vcabbage/levels54/docs/levels54-keymap.pdf

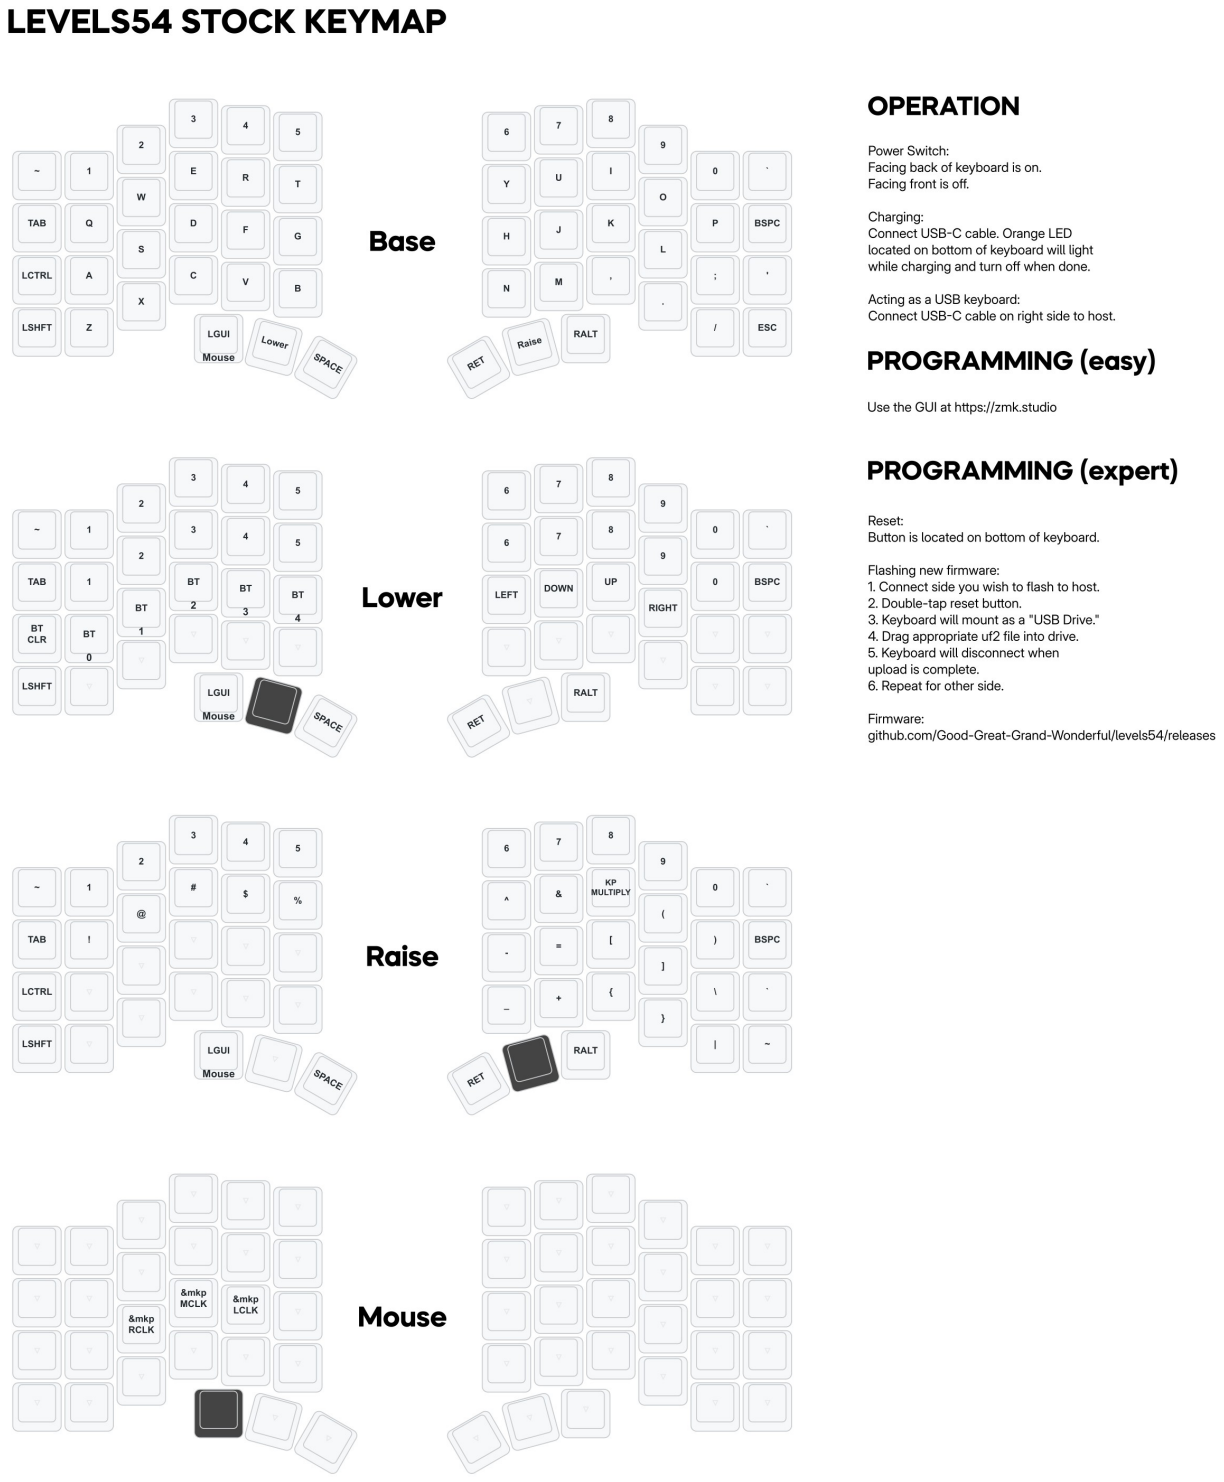
[picture p1: page 1]
