vcabbage/levels54/docs/manu-page1.pdf

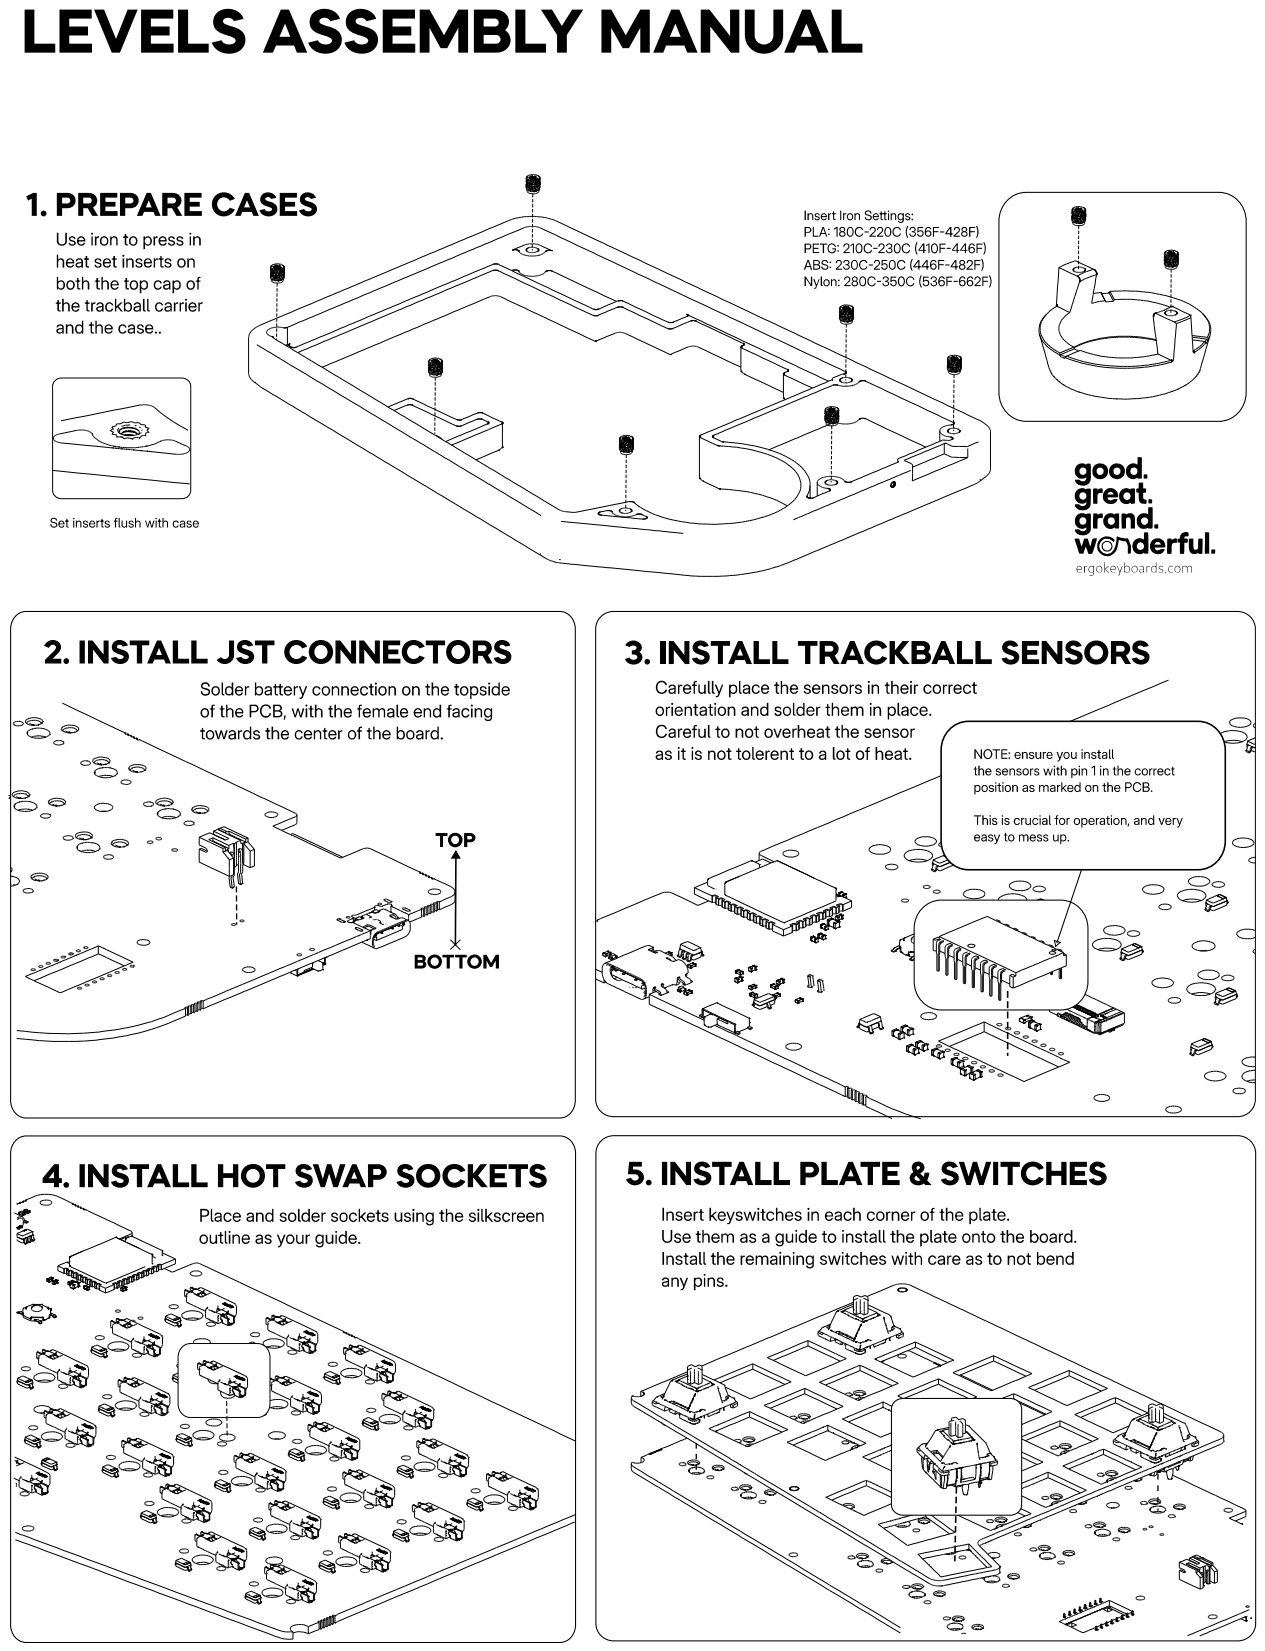
[picture p2: page 1]
