vcabbage/levels54/docs/manu-page2.pdf

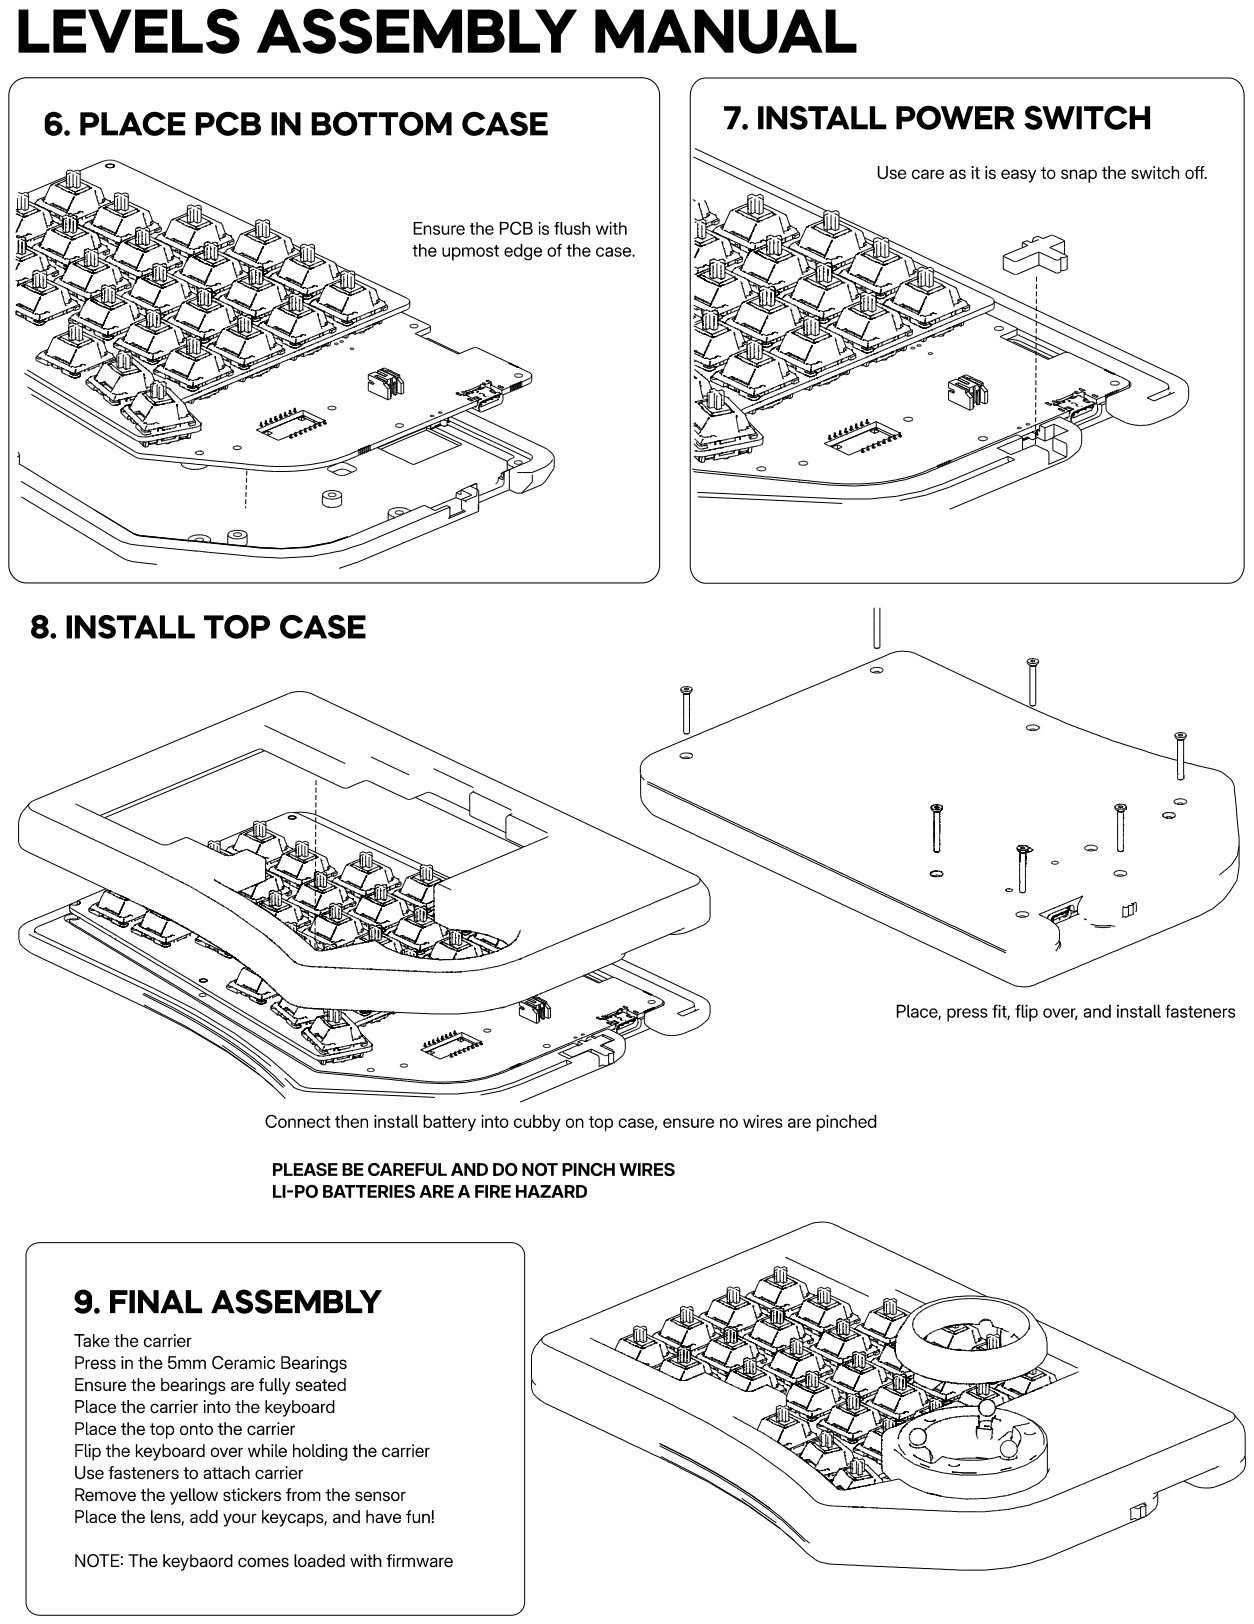
[picture p3: page 1]
