vcabbage/levels54/kicad/levels.kicad_pcb

## KiCad design kicad/levels.kicad_pcb (2026-05-02)

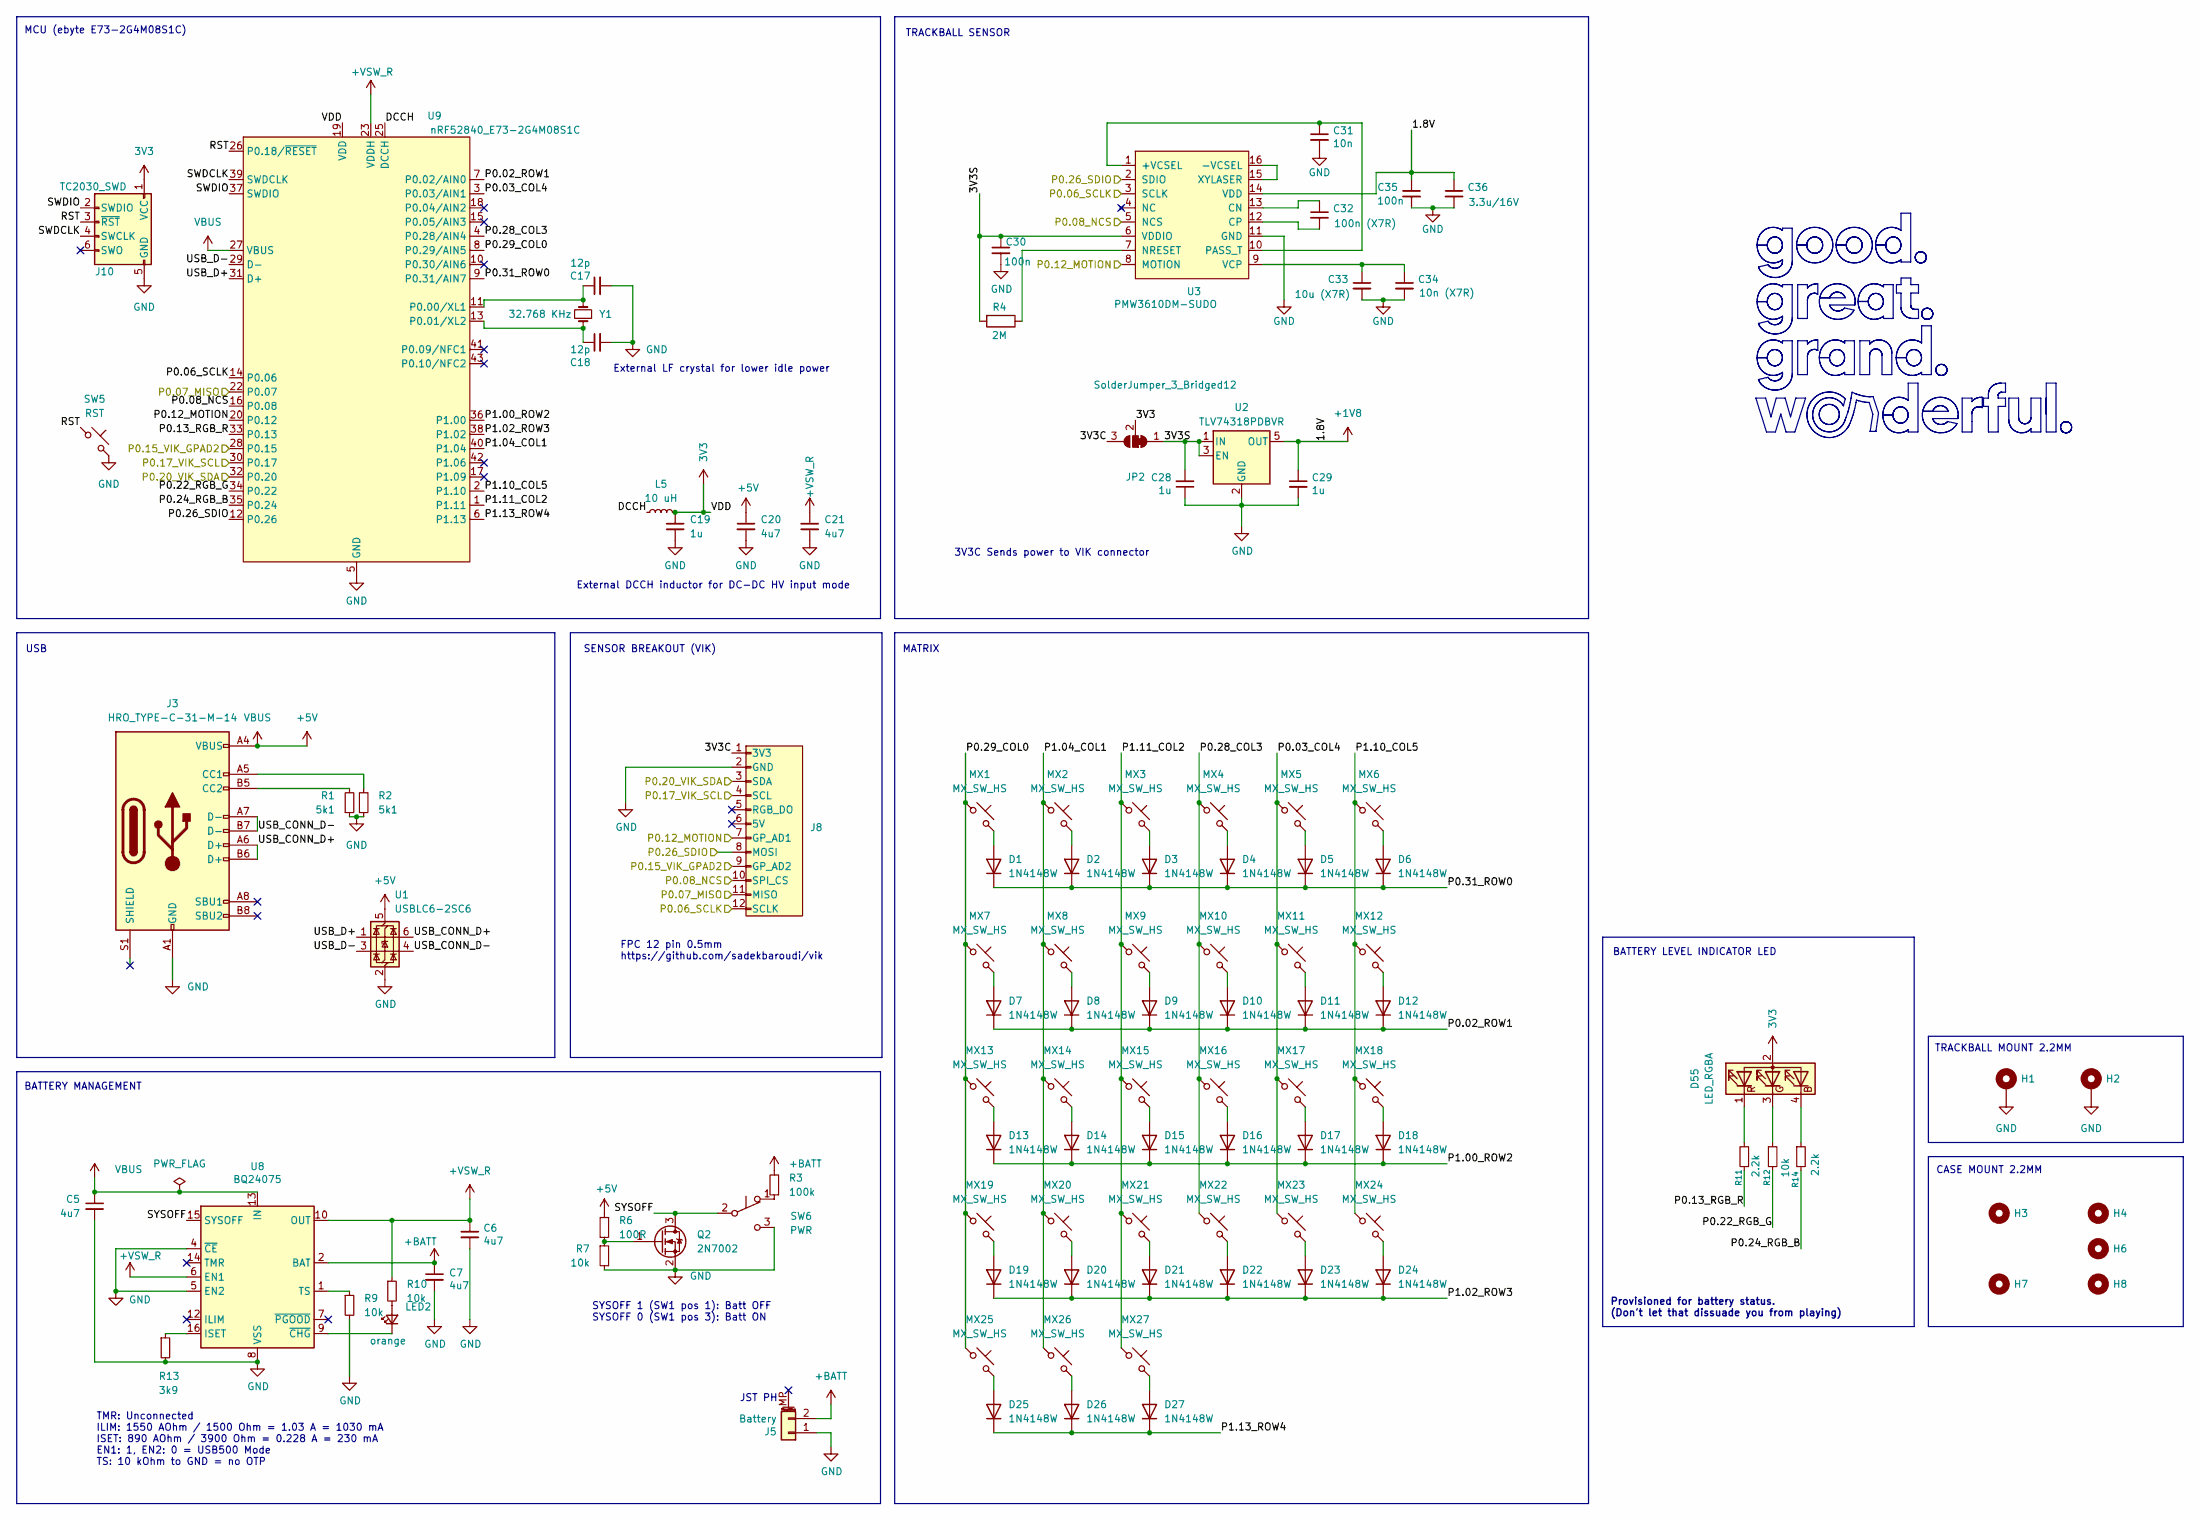
[picture p4: schematic matrix.kicad_sch, Levels]

Parts:
C5, C6, C7, C20, C21: 4u7; C_0402_1005Metric
C17, C18: 12p; C_0402_1005Metric
C19: 1u; C_0402_1005Metric
C28, C29: 1u; C_0603_1608Metric; LCSC C15849
C30, C35: 100n; C_0603_1608Metric; LCSC C14663
C31: 10n; C_0603_1608Metric; LCSC C57112
C32: 100n (X7R); C_0603_1608Metric; LCSC C14663
C33: 10u (X7R); C_0603_1608Metric; LCSC C237435
C34: 10n (X7R); C_0603_1608Metric; LCSC C57112
C36: 3.3u/16V; C_0603_1608Metric; LCSC C342962
D1, D2, D3, D4, D5, D6, D7, D8, D9, D10, D11, D12, D13, D14, D15, D16, D17, D18, D19, D20, D21, D22, D23, D24, D25, D26, D27: 1N4148W; D_SOD-123
D55: LED_RGBA; LED_NH-B1515RGBA-HF
H1, H2: MountingHole_Pad; MountingHole_2.2mm_M2_ISO7380_Pad
H3, H4, H6, H7: MountingHole; MountingHole_3.2mm_M3_DIN965
H8: MountingHole; MountingHole_2.2mm_M2_ISO7380
J3: HRO_TYPE-C-31-M-14; USB_C_Receptacle_HRO_TYPE-C-31-M-14
J5: Battery; JST_PH_S2B-PH-K_1x02_P2.00mm_Horizontal; LCSC C505023
J8: vik-keyboard-connector-horizontal
J10: TC2030_SWD; CON_TC2030_outlined
JP2: SolderJumper_3_Bridged12; SolderJumper-3_P1.3mm_Bridged12_RoundedPad1.0x1.5mm_NumberL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
L5: 10 uH; L_0603_1608Metric; LCSC C92982
LED2: orange; LED_0402_1005Metric
MX1, MX2, MX3, MX4, MX5, MX6, MX7, MX8, MX9, MX10, MX11, MX12, MX13, MX14, MX15, MX16, MX17, MX18, MX19, MX20, MX21, MX22, MX23, MX24, MX25, MX26, MX27: MX_SW_HS; SW_MX_HS_CPG151101S11_1u
Q2: 2N7002; SOT-23
R1, R2: 5k1; R_0402_1005Metric
R3: 100k; R_0402_1005Metric
R4: 2M; R_0603_1608Metric; LCSC C22976
R6: 100R; R_0402_1005Metric
R7, R9, R10, R12: 10k; R_0402_1005Metric
R11, R14: 2.2k; R_0402_1005Metric
R13: 3k9; R_0402_1005Metric
SW5: RST; SW_SPST_SKQG_WithStem
SW6: PWR; SW_MSK12C02-HB
U1: USBLC6-2SC6; SOT-23-6
U2: TLV74318PDBVR; SOT-23-5; LCSC C485152
U3: PMW3610DM-SUDO; PMW3610DM-SUDU 16Pin
U8: BQ24075; VQFN-16-1EP_3x3mm_P0.5mm_EP1.6x1.6mm
U9: nRF52840_E73-2G4M08S1C; LCSC C356849
Y1: 32.768 KHz; Crystal_SMD_2012-2Pin_2.0x1.2mm; LCSC C55208

Connections:
3V3: C19.1, D55.2 (A), J10.1 (VCC), JP2.2 (C), L5.2, U9.19 (VDD); also elsewhere on the board
+1V8: C29.1, C35.1, C36.1, U2.5 (OUT), U3.14 (VDD); also elsewhere on the board
+5V: C5.1, C20.1, J3.A4 (VBUS), J3.A9 (VBUS), J3.B4 (VBUS), J3.B9 (VBUS), R6.1, U1.5 (VBUS), U8.13 (IN), U9.27 (VBUS); also elsewhere on the board
+BATT: C7.1, J5.2, R3.2, U8.2 (BAT), U8.3 (BAT); also elsewhere on the board
+VSW_R: C6.1, C21.1, R10.1, U8.6 (EN1), U8.10 (OUT), U8.11 (OUT), U9.23 (VDDH)
/Right/3V3C: J8.1 (3V3), JP2.3 (B)
/Right/3V3S: C28.2, C30.1, JP2.1 (A), R4.2, U2.1 (IN), U2.3 (EN), U3.6 (VDDIO)
/Right/DCCH: L5.1, U9.25 (DCCH)
/Right/P0.02_ROW1: D7.1 (K), D8.1 (K), D9.1 (K), D10.1 (K), D11.1 (K), D12.1 (K), U9.7 (P0.02/AIN0)
/Right/P0.03_COL4: MX5.1, MX11.1, MX17.1, MX23.1, U9.3 (P0.03/AIN1)
/Right/P0.06_SCLK: J8.12 (SCLK), U3.3 (SCLK), U9.14 (P0.06)
/Right/P0.07_MISO: J8.11 (MISO), U9.22 (P0.07)
/Right/P0.08_NCS: J8.10 (SPI_CS), U3.5 (NCS), U9.16 (P0.08)
/Right/P0.12_MOTION: J8.7 (GP_AD1), U3.8 (MOTION), U9.20 (P0.12)
/Right/P0.13_RGB_R: R11.1, U9.33 (P0.13)
/Right/P0.15_VIK_GPAD2: J8.9 (GP_AD2), U9.28 (P0.15)
/Right/P0.17_VIK_SCL: J8.4 (SCL), U9.30 (P0.17)
/Right/P0.20_VIK_SDA: J8.3 (SDA), U9.32 (P0.20)
/Right/P0.22_RGB_G: R12.2, U9.34 (P0.22)
/Right/P0.24_RGB_B: R14.2, U9.35 (P0.24)
/Right/P0.26_SDIO: J8.8 (MOSI), U3.2 (SDIO), U9.12 (P0.26)
/Right/P0.28_COL3: MX4.1, MX10.1, MX16.1, MX22.1, U9.4 (P0.28/AIN4)
/Right/P0.29_COL0: MX1.1, MX7.1, MX13.1, MX19.1, MX25.1, U9.8 (P0.29/AIN5)
/Right/P0.31_ROW0: D1.1 (K), D2.1 (K), D3.1 (K), D4.1 (K), D5.1 (K), D6.1 (K), U9.9 (P0.31/AIN7)
/Right/P1.00_ROW2: D13.1 (K), D14.1 (K), D15.1 (K), D16.1 (K), D17.1 (K), D18.1 (K), U9.36 (P1.00)
/Right/P1.02_ROW3: D19.1 (K), D20.1 (K), D21.1 (K), D22.1 (K), D23.1 (K), D24.1 (K), U9.38 (P1.02)
/Right/P1.04_COL1: MX2.1, MX8.1, MX14.1, MX20.1, MX26.1, U9.40 (P1.04)
/Right/P1.10_COL5: MX6.1, MX12.1, MX18.1, MX24.1, U9.2 (P1.10)
/Right/P1.11_COL2: MX3.1, MX9.1, MX15.1, MX21.1, MX27.1, U9.1 (P1.11)
/Right/P1.13_ROW4: D25.1 (K), D26.1 (K), D27.1 (K), U9.6 (P1.13)
/Right/RST: J10.3 (~RST), SW5.1, U9.26 (P0.18/~RESET)
/Right/SWDCLK: J10.4 (SWCLK), U9.39 (SWDCLK)
/Right/SWDIO: J10.2 (SWDIO), U9.37 (SWDIO)
/Right/SYSOFF: Q2.3 (D), SW6.2 (B), U8.15 (SYSOFF)
/Right/USB_CONN_D+: J3.A6 (D+), J3.B6 (D+), U1.6 (I/O1)
/Right/USB_CONN_D-: J3.A7 (D-), J3.B7 (D-), U1.4 (I/O2)
/Right/USB_D+: U1.1 (I/O1), U9.31 (D+)
/Right/USB_D-: U1.3 (I/O2), U9.29 (D-)
GND: C5.2, C6.2, C7.2, C17.2, C18.2, C19.2, C20.2, C21.2, C28.1, C29.2, C30.2, C31.2, C33.2, C34.2, C35.2, C36.2, H1.1, H2.1, J3.A1 (GND), J3.A12 (GND), J3.B1 (GND), J3.B12 (GND), J5.1, J8.2 (GND), J10.5 (GND), Q2.2 (S), R1.1, R2.1, R7.2, R9.2, R13.2, SW5.2, SW6.3 (C), U1.2 (GND), U2.2 (GND), U3.11 (GND), U8.4 (~CE), U8.5 (EN2), U8.8 (VSS), U8.17 (VSS), U9.5 (GND), U9.21 (GND), U9.24 (GND); also elsewhere on the board
unnamed: D1.2 (A), MX1.2
unnamed: D2.2 (A), MX2.2
unnamed: D3.2 (A), MX3.2
unnamed: D4.2 (A), MX4.2
unnamed: D5.2 (A), MX5.2
unnamed: D6.2 (A), MX6.2
unnamed: D7.2 (A), MX7.2
unnamed: D8.2 (A), MX8.2
unnamed: D9.2 (A), MX9.2
unnamed: D10.2 (A), MX10.2
unnamed: D11.2 (A), MX11.2
unnamed: D12.2 (A), MX12.2
unnamed: D13.2 (A), MX13.2
unnamed: D14.2 (A), MX14.2
unnamed: D15.2 (A), MX15.2
unnamed: D16.2 (A), MX16.2
unnamed: D17.2 (A), MX17.2
unnamed: D18.2 (A), MX18.2
unnamed: D19.2 (A), MX19.2
unnamed: D20.2 (A), MX20.2
unnamed: D21.2 (A), MX21.2
unnamed: D22.2 (A), MX22.2
unnamed: D23.2 (A), MX23.2
unnamed: D24.2 (A), MX24.2
unnamed: D25.2 (A), MX25.2
unnamed: D26.2 (A), MX26.2
unnamed: D27.2 (A), MX27.2
unnamed: D55.4 (BK), R14.1
unnamed: D55.3 (GK), R12.1
unnamed: D55.1 (RK), R11.2
unnamed: J3.A5 (CC1), R2.2
unnamed: J3.B5 (CC2), R1.2
unnamed: LED2.2 (A), R10.2
unnamed: LED2.1 (K), U8.9 (~CHG)
unnamed: Q2.1 (G), R6.2, R7.1
unnamed: R3.1, SW6.1 (A)
unnamed: C31.1, U3.1 (+VCSEL), U3.10 (PASS_T)
unnamed: U3.15 (XYLASER), U3.16 (-VCSEL)
unnamed: C32.1, U3.13 (CN)
unnamed: C32.2, U3.12 (CP)
unnamed: R4.1, U3.7 (NRESET)
unnamed: C33.1, C34.1, U3.9 (VCP)
unnamed: R13.1, U8.16 (ISET)
unnamed: R9.1, U8.1 (TS)
unnamed: C17.1, U9.11 (P0.00/XL1), Y1.2
unnamed: C18.1, U9.13 (P0.01/XL2), Y1.1

Notes on the sheet:
BATTERY LEVEL INDICATOR LED
JST PH
Provisioned for battery status. (Don't let that dissuade you from playing)
MCU (ebyte E73-2G4M08S1C)
TRACKBALL SENSOR
SENSOR BREAKOUT (VIK)
TMR: Unconnected ILIM: 1550 AOhm / 1500 Ohm = 1.03 A = 1030 mA ISET: 890 AOhm / 3900 Ohm = 0.228 A = 230 mA EN1: 1, EN2: 0 = USB500 Mode TS: 10 kOhm to GND = no OTP
FPC 12 pin 0.5mm https://github.com/sadekbaroudi/vik
BATTERY MANAGEMENT
USB
CASE MOUNT 2.2MM
3V3C Sends power to VIK connector
External LF crystal for lower idle power
MATRIX
SYSOFF 1 (SW1 pos 1): Batt OFF SYSOFF 0 (SW1 pos 3): Batt ON
External DCCH inductor for DC-DC HV input mode
TRACKBALL MOUNT 2.2MM

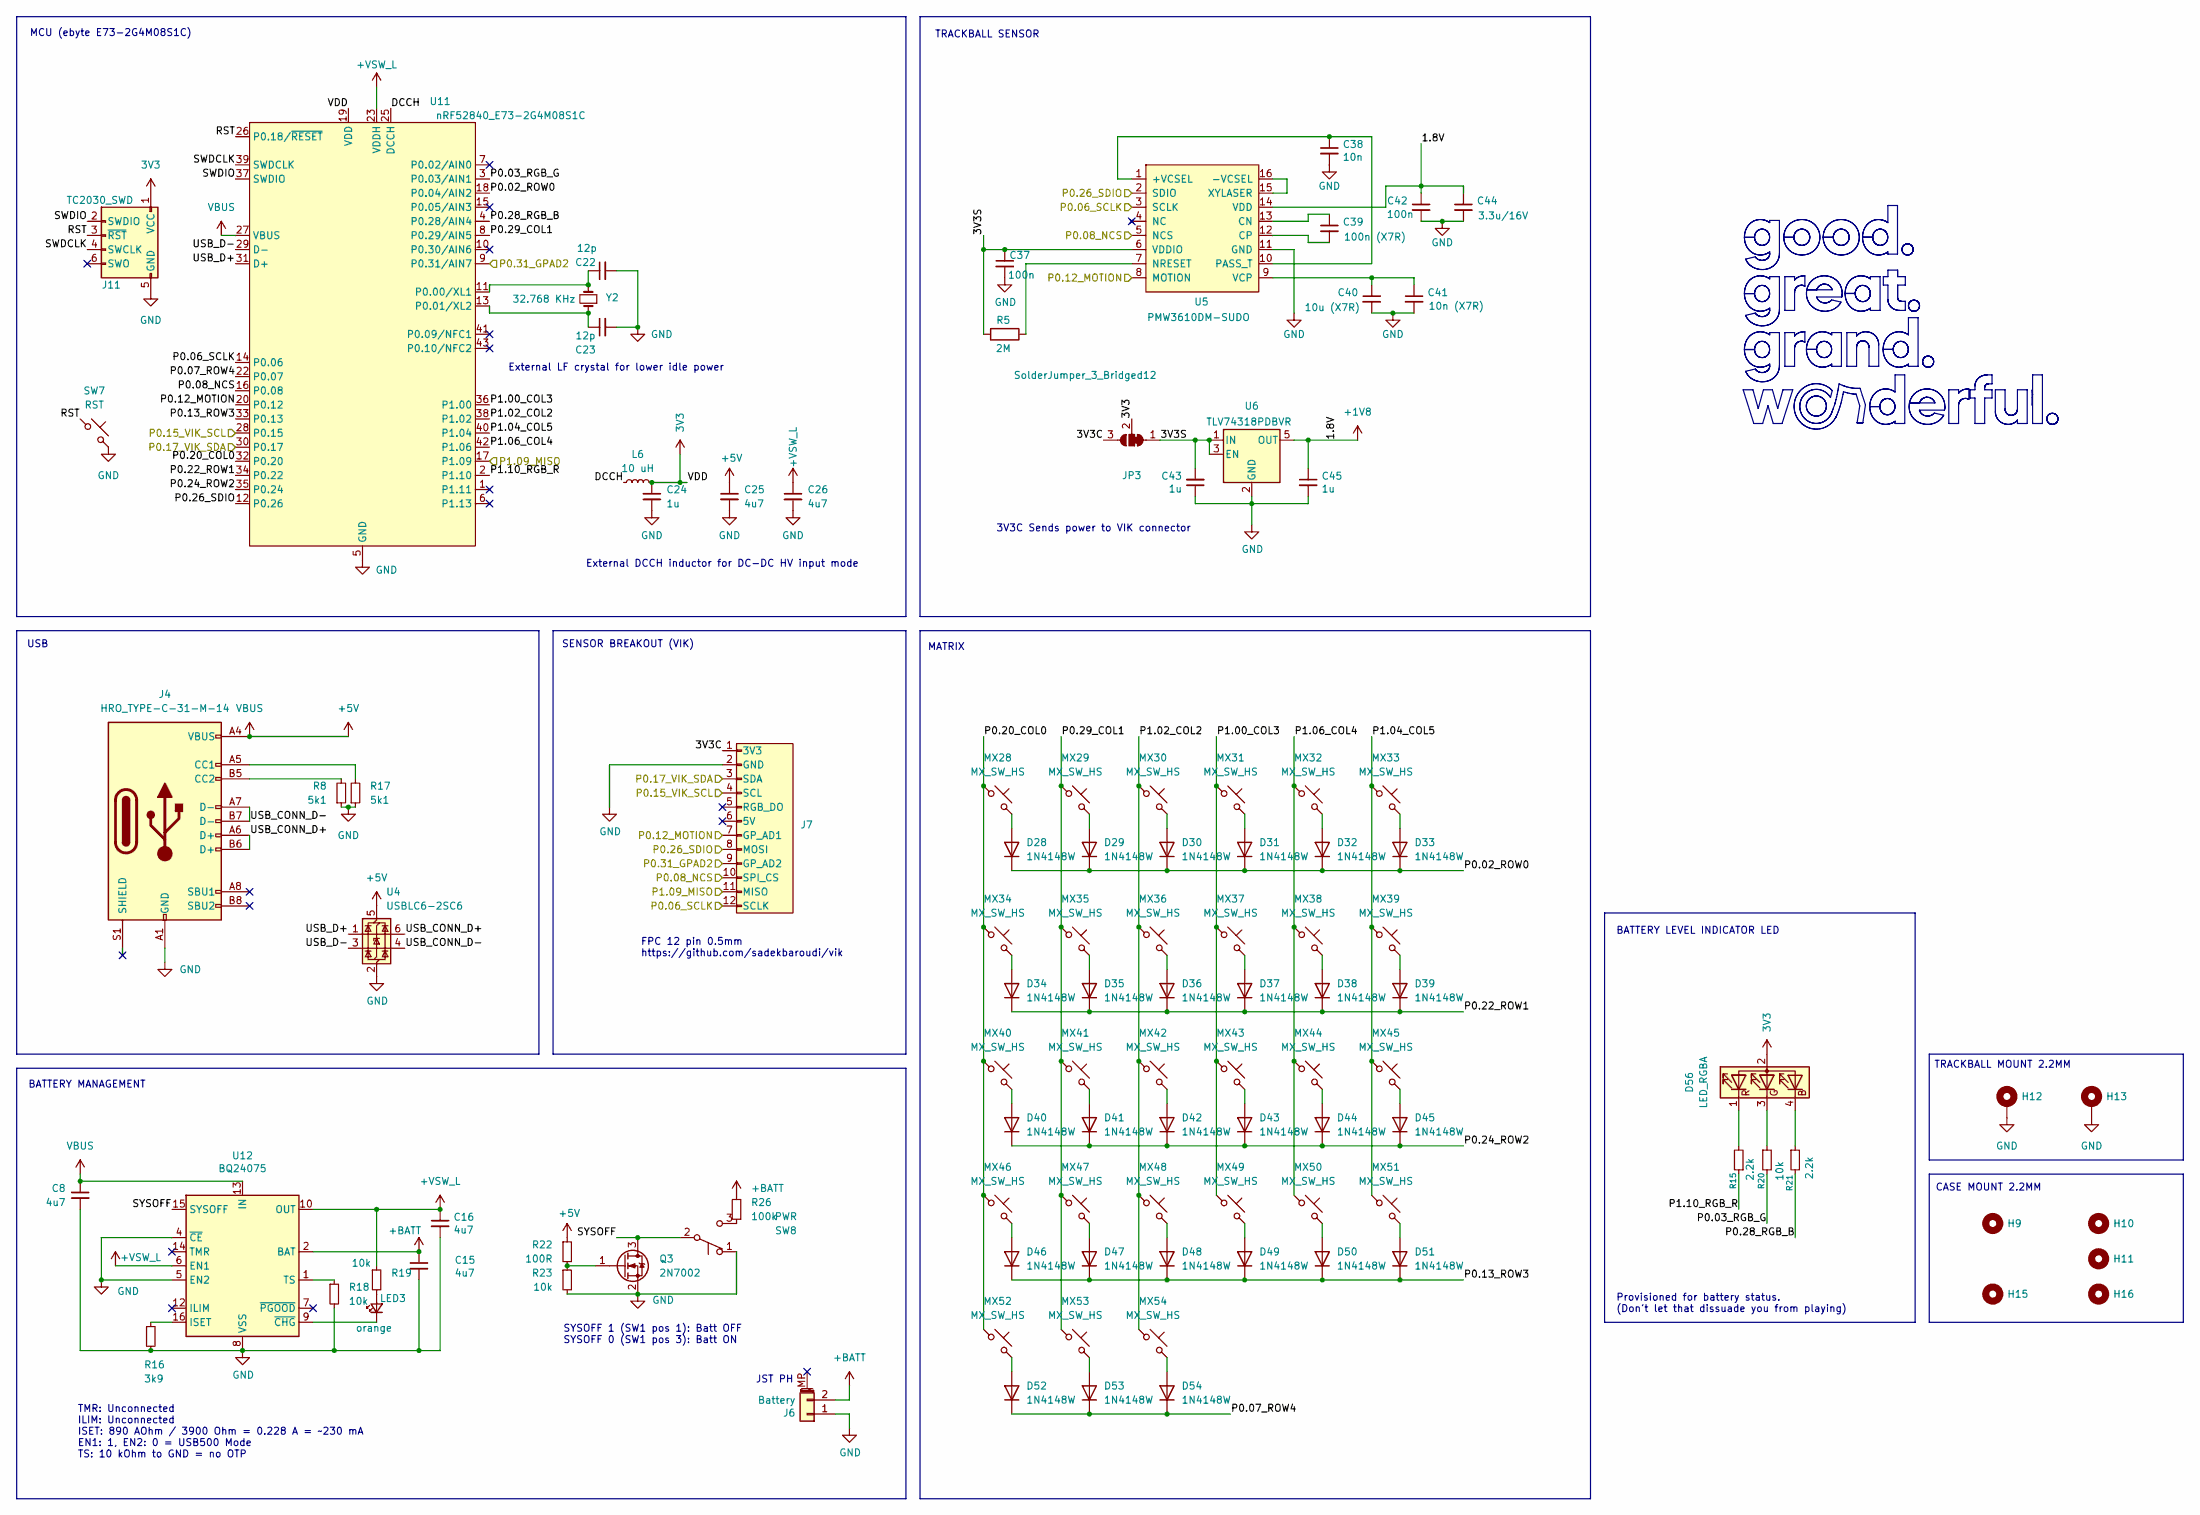
[picture p5: schematic LeftMatrix.kicad_sch, Levels]

Parts:
C8, C15, C16, C25, C26: 4u7; C_0402_1005Metric
C22, C23: 12p; C_0402_1005Metric
C24: 1u; C_0402_1005Metric
C37, C42: 100n; C_0603_1608Metric; LCSC C14663
C38: 10n; C_0603_1608Metric; LCSC C57112
C39: 100n (X7R); C_0603_1608Metric; LCSC C14663
C40: 10u (X7R); C_0603_1608Metric; LCSC C237435
C41: 10n (X7R); C_0603_1608Metric; LCSC C57112
C43, C45: 1u; C_0603_1608Metric; LCSC C15849
C44: 3.3u/16V; C_0603_1608Metric; LCSC C342962
D28, D29, D30, D31, D32, D33, D34, D35, D36, D37, D38, D39, D40, D41, D42, D43, D44, D45, D46, D47, D48, D49, D50, D51, D52, D53, D54: 1N4148W; D_SOD-123
D56: LED_RGBA; LED_NH-B1515RGBA-HF
H9, H10, H11, H15: MountingHole; MountingHole_2.2mm_M2_ISO7380
H12, H13: MountingHole_Pad; MountingHole_2.2mm_M2_ISO7380_Pad
H16: MountingHole; MountingHole_3.2mm_M3_DIN965
J4: HRO_TYPE-C-31-M-14; USB_C_Receptacle_HRO_TYPE-C-31-M-14
J6: Battery; JST_PH_S2B-PH-K_1x02_P2.00mm_Horizontal; LCSC C505023
J7: vik-keyboard-connector-horizontal
J11: TC2030_SWD; CON_TC2030_outlined
JP3: SolderJumper_3_Bridged12; SolderJumper-3_P1.3mm_Bridged12_RoundedPad1.0x1.5mm_NumberL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
L6: 10 uH; L_0603_1608Metric; LCSC C92982
LED3: orange; LED_0402_1005Metric
MX28, MX29, MX30, MX31, MX32, MX33, MX34, MX35, MX36, MX37, MX38, MX39, MX40, MX41, MX42, MX43, MX44, MX45, MX46, MX47, MX48, MX49, MX50, MX51, MX52, MX53, MX54: MX_SW_HS; SW_MX_HS_CPG151101S11_1u
Q3: 2N7002; SOT-23
R5: 2M; R_0603_1608Metric; LCSC C22976
R8, R17: 5k1; R_0402_1005Metric
R15, R21: 2.2k; R_0402_1005Metric
R16: 3k9; R_0402_1005Metric
R18, R19, R20, R23: 10k; R_0402_1005Metric
R22: 100R; R_0402_1005Metric
R26: 100k; R_0402_1005Metric
SW7: RST; SW_SPST_SKQG_WithStem
SW8: PWR; SW_MSK12C02-HB
U4: USBLC6-2SC6; SOT-23-6
U5: PMW3610DM-SUDO; PMW3610DM-SUDU 16Pin
U6: TLV74318PDBVR; SOT-23-5; LCSC C485152
U11: nRF52840_E73-2G4M08S1C; LCSC C356849
U12: BQ24075; VQFN-16-1EP_3x3mm_P0.5mm_EP1.6x1.6mm
Y2: 32.768 KHz; Crystal_SMD_2012-2Pin_2.0x1.2mm; LCSC C55208

Connections:
3V3: C24.1, D56.2 (A), J11.1 (VCC), JP3.2 (C), L6.2, U11.19 (VDD); also elsewhere on the board
+1V8: C42.1, C44.1, C45.1, U5.14 (VDD), U6.5 (OUT); also elsewhere on the board
+5V: C8.1, C25.1, J4.A4 (VBUS), J4.A9 (VBUS), J4.B4 (VBUS), J4.B9 (VBUS), R22.1, U4.5 (VBUS), U11.27 (VBUS), U12.13 (IN); also elsewhere on the board
+BATT: C15.1, J6.2, R26.2, U12.2 (BAT), U12.3 (BAT); also elsewhere on the board
+VSW_L: C16.1, C26.1, R19.1, U11.23 (VDDH), U12.6 (EN1), U12.10 (OUT), U12.11 (OUT)
/Left/3V3C: J7.1 (3V3), JP3.3 (B)
/Left/3V3S: C37.1, C43.2, JP3.1 (A), R5.2, U5.6 (VDDIO), U6.1 (IN), U6.3 (EN)
/Left/DCCH: L6.1, U11.25 (DCCH)
/Left/P0.02_ROW0: D28.1 (K), D29.1 (K), D30.1 (K), D31.1 (K), D32.1 (K), D33.1 (K), U11.18 (P0.04/AIN2)
/Left/P0.03_RGB_G: R20.2, U11.3 (P0.03/AIN1)
/Left/P0.06_SCLK: J7.12 (SCLK), U5.3 (SCLK), U11.14 (P0.06)
/Left/P0.07_ROW4: D52.1 (K), D53.1 (K), D54.1 (K), U11.22 (P0.07)
/Left/P0.08_NCS: J7.10 (SPI_CS), U5.5 (NCS), U11.16 (P0.08)
/Left/P0.12_MOTION: J7.7 (GP_AD1), U5.8 (MOTION), U11.20 (P0.12)
/Left/P0.13_ROW3: D46.1 (K), D47.1 (K), D48.1 (K), D49.1 (K), D50.1 (K), D51.1 (K), U11.33 (P0.13)
/Left/P0.15_VIK_SCL: J7.4 (SCL), U11.28 (P0.15)
/Left/P0.17_VIK_SDA: J7.3 (SDA), U11.30 (P0.17)
/Left/P0.20_COL0: MX28.1, MX34.1, MX40.1, MX46.1, MX52.1, U11.32 (P0.20)
/Left/P0.22_ROW1: D34.1 (K), D35.1 (K), D36.1 (K), D37.1 (K), D38.1 (K), D39.1 (K), U11.34 (P0.22)
/Left/P0.24_ROW2: D40.1 (K), D41.1 (K), D42.1 (K), D43.1 (K), D44.1 (K), D45.1 (K), U11.35 (P0.24)
/Left/P0.26_SDIO: J7.8 (MOSI), U5.2 (SDIO), U11.12 (P0.26)
/Left/P0.28_RGB_B: R21.2, U11.4 (P0.28/AIN4)
/Left/P0.29_COL1: MX29.1, MX35.1, MX41.1, MX47.1, MX53.1, U11.8 (P0.29/AIN5)
/Left/P0.31_GPAD2: J7.9 (GP_AD2), U11.9 (P0.31/AIN7)
/Left/P1.00_COL3: MX31.1, MX37.1, MX43.1, MX49.1, U11.36 (P1.00)
/Left/P1.02_COL2: MX30.1, MX36.1, MX42.1, MX48.1, MX54.1, U11.38 (P1.02)
/Left/P1.04_COL5: MX33.1, MX39.1, MX45.1, MX51.1, U11.40 (P1.04)
/Left/P1.06_COL4: MX32.1, MX38.1, MX44.1, MX50.1, U11.42 (P1.06)
/Left/P1.09_MISO: J7.11 (MISO), U11.17 (P1.09)
/Left/P1.10_RGB_R: R15.1, U11.2 (P1.10)
/Left/RST: J11.3 (~RST), SW7.1, U11.26 (P0.18/~RESET)
/Left/SWDCLK: J11.4 (SWCLK), U11.39 (SWDCLK)
/Left/SWDIO: J11.2 (SWDIO), U11.37 (SWDIO)
/Left/SYSOFF: Q3.3 (D), SW8.2 (B), U12.15 (SYSOFF)
/Left/USB_CONN_D+: J4.A6 (D+), J4.B6 (D+), U4.6 (I/O1)
/Left/USB_CONN_D-: J4.A7 (D-), J4.B7 (D-), U4.4 (I/O2)
/Left/USB_D+: U4.1 (I/O1), U11.31 (D+)
/Left/USB_D-: U4.3 (I/O2), U11.29 (D-)
GND: C8.2, C15.2, C16.2, C22.2, C23.2, C24.2, C25.2, C26.2, C37.2, C38.2, C40.2, C41.2, C42.2, C43.1, C44.2, C45.2, H12.1, H13.1, J4.A1 (GND), J4.A12 (GND), J4.B1 (GND), J4.B12 (GND), J6.1, J7.2 (GND), J11.5 (GND), Q3.2 (S), R8.1, R16.2, R17.1, R18.2, R23.2, SW7.2, SW8.1 (A), U4.2 (GND), U5.11 (GND), U6.2 (GND), U11.5 (GND), U11.21 (GND), U11.24 (GND), U12.4 (~CE), U12.5 (EN2), U12.8 (VSS), U12.17 (VSS); also elsewhere on the board
unnamed: D28.2 (A), MX28.2
unnamed: D29.2 (A), MX29.2
unnamed: D30.2 (A), MX30.2
unnamed: D31.2 (A), MX31.2
unnamed: D32.2 (A), MX32.2
unnamed: D33.2 (A), MX33.2
unnamed: D34.2 (A), MX34.2
unnamed: D35.2 (A), MX35.2
unnamed: D36.2 (A), MX36.2
unnamed: D37.2 (A), MX37.2
unnamed: D38.2 (A), MX38.2
unnamed: D39.2 (A), MX39.2
unnamed: D40.2 (A), MX40.2
unnamed: D41.2 (A), MX41.2
unnamed: D42.2 (A), MX42.2
unnamed: D43.2 (A), MX43.2
unnamed: D44.2 (A), MX44.2
unnamed: D45.2 (A), MX45.2
unnamed: D46.2 (A), MX46.2
unnamed: D47.2 (A), MX47.2
unnamed: D48.2 (A), MX48.2
unnamed: D49.2 (A), MX49.2
unnamed: D50.2 (A), MX50.2
unnamed: D51.2 (A), MX51.2
unnamed: D52.2 (A), MX52.2
unnamed: D53.2 (A), MX53.2
unnamed: D54.2 (A), MX54.2
unnamed: D56.4 (BK), R21.1
unnamed: D56.3 (GK), R20.1
unnamed: D56.1 (RK), R15.2
unnamed: J4.A5 (CC1), R17.2
unnamed: J4.B5 (CC2), R8.2
unnamed: LED3.2 (A), R19.2
unnamed: LED3.1 (K), U12.9 (~CHG)
unnamed: Q3.1 (G), R22.2, R23.1
unnamed: R26.1, SW8.3 (C)
unnamed: C38.1, U5.1 (+VCSEL), U5.10 (PASS_T)
unnamed: U5.15 (XYLASER), U5.16 (-VCSEL)
unnamed: C39.1, U5.13 (CN)
unnamed: C39.2, U5.12 (CP)
unnamed: R5.1, U5.7 (NRESET)
unnamed: C40.1, C41.1, U5.9 (VCP)
unnamed: C22.1, U11.11 (P0.00/XL1), Y2.2
unnamed: C23.1, U11.13 (P0.01/XL2), Y2.1
unnamed: R16.1, U12.16 (ISET)
unnamed: R18.1, U12.1 (TS)

Notes on the sheet:
External LF crystal for lower idle power
JST PH
BATTERY MANAGEMENT
Provisioned for battery status. (Don't let that dissuade you from playing)
BATTERY LEVEL INDICATOR LED
TRACKBALL MOUNT 2.2MM
CASE MOUNT 2.2MM
USB
External DCCH inductor for DC-DC HV input mode
MATRIX
TRACKBALL SENSOR
3V3C Sends power to VIK connector
FPC 12 pin 0.5mm https://github.com/sadekbaroudi/vik
TMR: Unconnected ILIM: Unconnected ISET: 890 AOhm / 3900 Ohm = 0.228 A = ~230 mA EN1: 1, EN2: 0 = USB500 Mode TS: 10 kOhm to GND = no OTP
SENSOR BREAKOUT (VIK)
MCU (ebyte E73-2G4M08S1C)
SYSOFF 1 (SW1 pos 1): Batt OFF SYSOFF 0 (SW1 pos 3): Batt ON

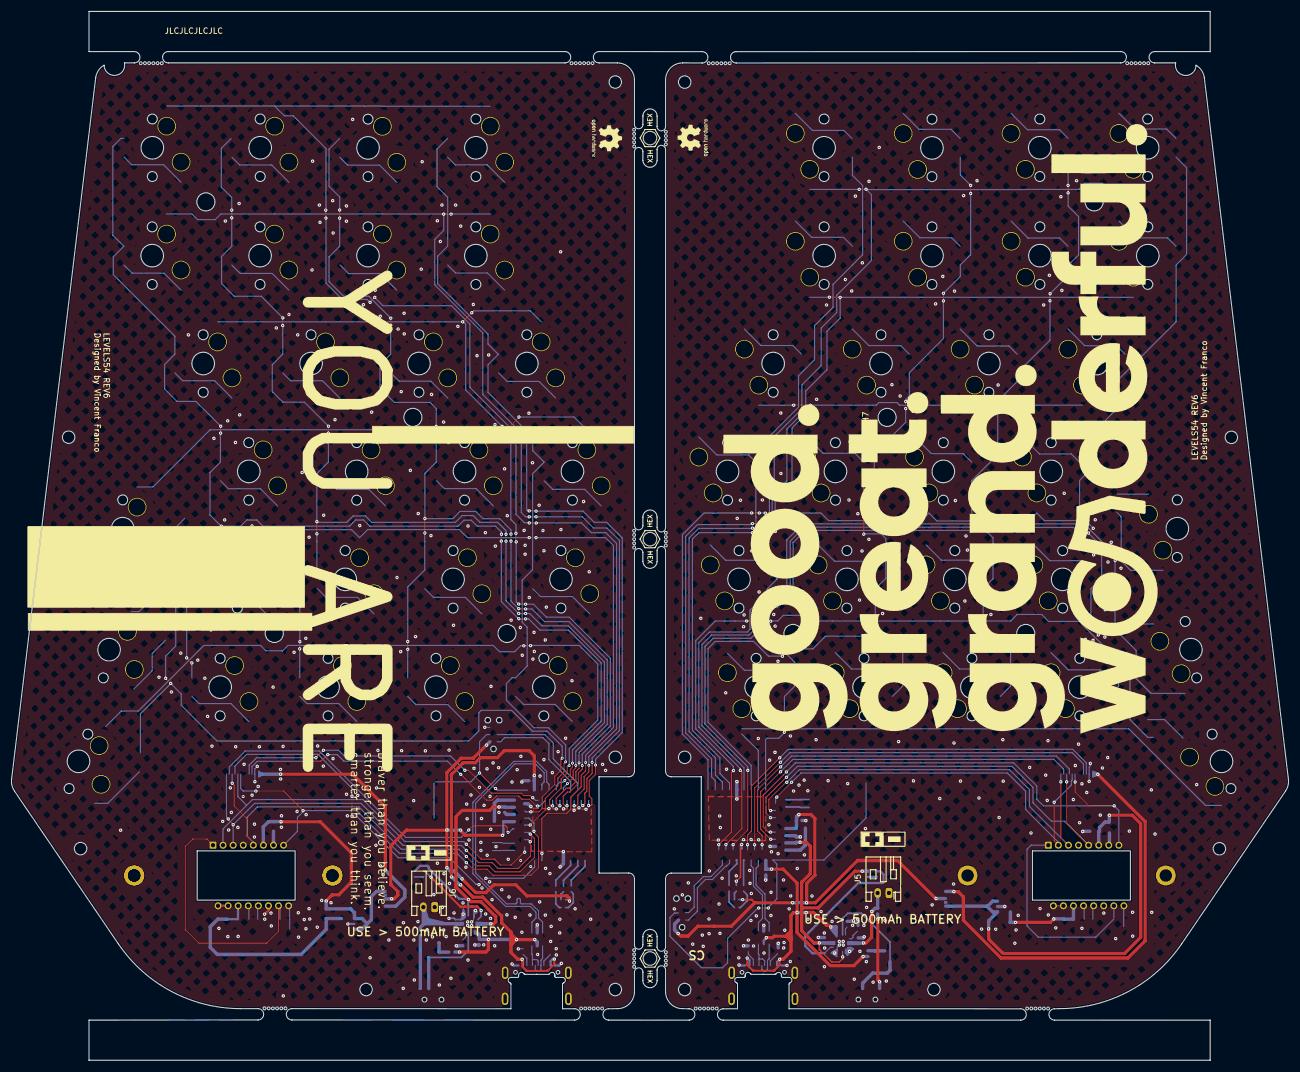
[picture p6: board levels.kicad_pcb from above]

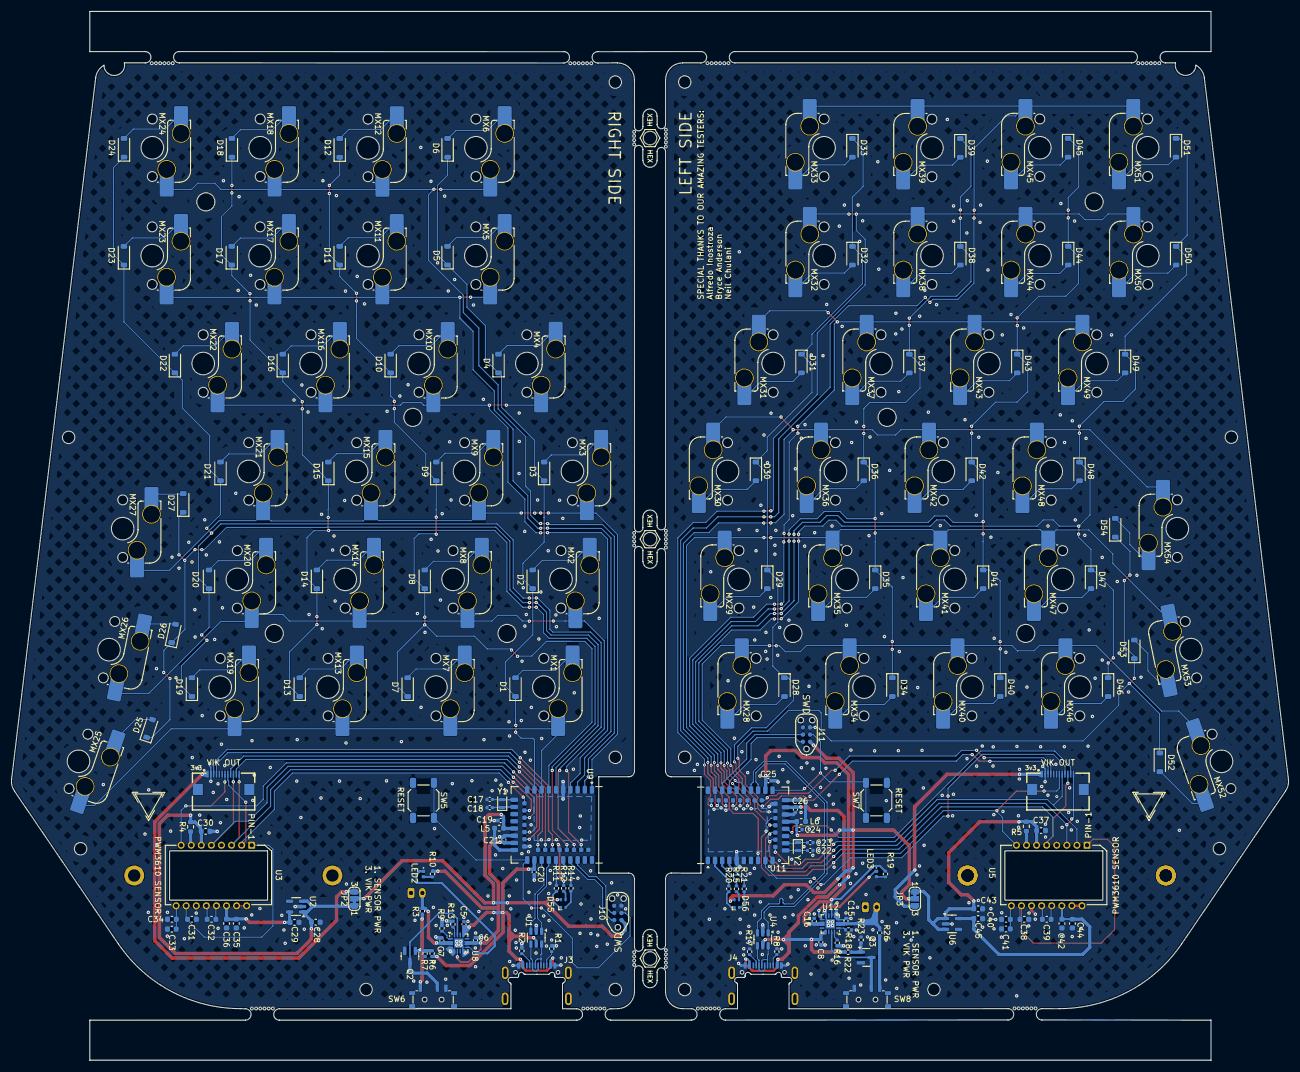
[picture p7: board levels.kicad_pcb from below]

Board: 2 copper layers, 225.5 x 185.2 mm, 229 parts (201 on the bottom side), 165 nets.

Other parts of the board:
H1#2, H2#2: MountingHole_Pad; MountingHole_2.2mm_M2_ISO7380_Pad
H3#2, H4#2, H7#2: MountingHole; MountingHole_3.2mm_M3_DIN965
H8#2, H8#3, H8#4, H8#5, H8#6, H8#7, H8#8: MountingHole; MountingHole_2.2mm_M2_ISO7380
MB5, MB5#2, MB5#3: 5.5mm; mousebites_5p5mm_easysnap

Their connections:
GND: H1#2.1, H2#2.1; also elsewhere on the board
